huzican/15th_SmartCar_SoundBeacon/code/README.md

- SoundBeacon是最终比赛代码，规则是声音信标组

- RBRB(image)是11月出的多灯光电信标组，当年做过信标组的兄弟都知道，信标组3月份才从光电改成声音信号，还碰上疫情和赛事挂名单位改革，真的是太难了那年

- fft是matlab测试傅里叶加速算法
