huzican/15th_SmartCar_SoundBeacon/(list of files, drawings)

Other design files:
board/红黑红黑的小黄鸡二队主板/红黑红黑的小黄鸡二队区赛2.0.PcbDoc
board/红黑红黑的小黄鸡二队主板/红黑红黑的小黄鸡二队区赛2.0Mainboard.SchDoc
board/红黑红黑的小黄鸡二队驱动.PcbDoc
board/驱动区赛.SchDoc
board/龙邱MIC转接板.SchDoc
