huzican/15th_SmartCar_SoundBeacon/code/RBRB(image)/Main_RT/CODE/inc/Pid.h

#ifndef __PID_H__
#define __PID_H__

#include "common.h"


typedef struct PID
{
  float err_1,err_2,err_3;
  float err;
  float kp,ki,kd;
  float last_d,d_filter;
  int16 result;
}pid_t;


extern pid_t pid_F_L;
extern pid_t pid_F_R;
extern pid_t pid_B_L;
extern pid_t pid_B_R;
extern pid_t pid_far;
extern pid_t pid_near;
extern pid_t pid_yaw;
extern pid_t pid_yaw_rate;
extern float FP;
extern float NP;
extern float YP;
extern float YD;
extern float YRP;
extern float YRD;


void pid_init(void);
void pid_reset(pid_t *pid);
void pid_control(pid_t *pid, int16 actual, int16 set);

#endif
