huzican/15th_SmartCar_SoundBeacon/code/RBRB(image)/Main_RT/CODE/src/FuzzySet_Speed.c

#include "common.h"
#include "math.h"
#include "FuzzySet_Speed.h"
#include "Image.h"
#include "Motor.h"

const int16 PMAX = 75;
const int16 PMIN = 30;

int16 DMAX;
int16 DMIN;

const int16 SMAX = 100;     //两个参数都统一到0~100(归一化)
const int16 SMIN = 0;
const int16 FMAX = 100;     //语言值的满幅值
              //0   1   2   3   4   5   6
int16 PFF[7] = {0, 16, 32, 48, 64, 80, 96}; //统一到最大值；最小值
int16 DFF[7] = {0, 40, 50, 60, 70, 80, 90};
/***输出量U语言值特征点 0  1   2   3   4   5   6***/
int16 N_UFF1[7] = {200, 220, 240, 250, 260, 275, 290};
int16 F_UFF1[7] = {300, 320, 340, 360, 380, 400, 420};

int16 N_UFF2[7] = {200, 220, 230, 240, 250, 260, 270};
int16 F_UFF2[7] = {270, 280, 285, 295, 305, 320 ,335};

int16 N_UFF3[7] = {200, 220, 240, 250, 260, 275, 290};
int16 F_UFF3[7] = {300, 320, 340, 360, 380, 400 ,415};

int16 N_UFF4[7] = {200, 220, 240, 250, 260, 275, 290};
int16 F_UFF4[7] = {300, 320, 340, 360, 380, 400 ,415};

uint16 rule[7][7] =
{   /*Track_complexity */  //  0,  1,  2,  3,  4,  5,  6    Prospect_See
                  /* 0 */     {6,  5,  4,  3,  2,  1,  0,}, //U语言数组里面的下标
                  /* 1 */     {5,  5,  4,  3,  2,  1,  0,},      
                  /* 2 */     {4,  4,  3,  2,  1,  1,  0,},
                  /* 3 */     {3,  3,  3,  2,  1,  1,  0,},
                  /* 4 */     {2,  2,  2,  1,  1,  0,  0,},
                  /* 5 */     {2,  1,  1,  0,  0,  0,  0,}, 
                  /* 6 */     {1,  1,  0,  0,  0,  0,  0,}
};  //横D竖P

int16 *UFF;

//P代表赛道复杂程度
//D表示前瞻
//模糊控制算法通过这两个跟定量以及规则表给出当前应该输出的速度
int16 FuzzySet_Speed(int16 P, int16 D)
{
  int16 U;      //偏差，以及输出值的精确量
  uint16 PF[2];
  uint16 DF[2];
  uint16 UF[4]; //偏差，偏差微分以及输出值的隶属度 PF[1]是P的隶属度,PF[0]是隶属度的补集
  int16 Pn = 0, Dn = 0;
  int16 Un[4];
  int32 temp1, temp2;
  
  if(P < PMIN)
    P = PMIN;
  else if(P > PMAX)
    P = PMAX;
  P = (int16)((double)(P - PMIN)/(PMAX - PMIN)*(SMAX - SMIN) + SMIN);
  
  if(D < DMIN)
    D = DMIN;
  else if(D > DMAX)
    D = DMAX;
  D = (int16)((double)(D - DMIN)/(DMAX - DMIN)*(SMAX-SMIN)+SMIN);
  
  //隶属度的确定
  //根据PD的指定语言获得有效的隶属度
  if(P > PFF[0]&&P <PFF[6])
  {
    if(P <= PFF[1])
    {
      Pn = 1;
      PF[0] = (uint16)(FMAX *((float)(PFF[1]-P)/(PFF[1]-PFF[0])));
    }
    else if(P <= PFF[2])
    {
      Pn = 2;
      PF[0] = (uint16)(FMAX * ((float)(PFF[2]-P)/(PFF[2]-PFF[1])));
    }
    else if(P <= PFF[3])
    {
      Pn = 3;
      PF[0] = (uint16)(FMAX * ((float)(PFF[3]-P)/(PFF[3]-PFF[2])));
    }
    else if(P <= PFF[4])
    {
      Pn = 4;
      PF[0] = (uint16)(FMAX * ((float)(PFF[4]-P)/(PFF[4]-PFF[3])));
    }
    else if(P <= PFF[5])
    {
      Pn = 5;
      PF[0] = (uint16)(FMAX * ((float)(PFF[5]-P)/(PFF[5]-PFF[4])));
    }
    else if(P <= PFF[6])
    {
      Pn = 6;
      PF[0] = (uint16)(FMAX * ((float)(PFF[6]-P)/(PFF[6]-PFF[5])));
    }
  }
  else if(P <= PFF[0])
  {
    Pn = 1;
    PF[0] = (uint16)(FMAX);
  }
  else if(P >= PFF[6])
  {
    Pn=6;
    PF[0] = 0;
  }
  
  PF[1] = (uint16)(FMAX - PF[0]);
  
  if(D > DFF[0]&&D < DFF[6])
  {
    if(D <= DFF[1])
    {
      Dn = 1;
      DF[0] = (uint16)(FMAX * ((float)(DFF[1]-D)/(DFF[1]-DFF[0])));
    }
    else if(D <= DFF[2])
    {
      Dn = 2;
      DF[0] = (uint16)(FMAX * ((float)(DFF[2]-D)/(DFF[2]-DFF[1])));
    }
    else if(D <= DFF[3])
    {
      Dn = 3;
      DF[0] = (uint16)(FMAX * ((float)(DFF[3]-D)/(DFF[3]-DFF[2])));
    }
    else if(D <= DFF[4])
    {
      Dn = 4;
      DF[0] = (uint16)(FMAX * ((float)(DFF[4]-D)/(DFF[4]-DFF[3])));
    }
    else if(D <= DFF[5])
    {
      Dn = 5;
      DF[0] = (uint16)(FMAX * ((float)(DFF[5]-D)/(DFF[5]-DFF[4])));
    }
    else if(D <= DFF[6])
    {
      Dn = 6;
      DF[0] = (uint16)(FMAX * ((float)(DFF[6]-D)/(DFF[6]-DFF[5])));
    }
  }
  else if(D <= DFF[0])
  {
    Dn = 1;
    DF[0] = (uint16)(FMAX);
  }
  else if(D >= DFF[6])
  {
    Dn = 6;
    DF[0] = 0;
  }
  
  DF[1] = (uint16)(FMAX - DF[0]);
  
  //使用误差范围优化后的规则表rule[7][7]
  //输出值使用13个隶属函数，中心值由UFF[7]指定
  //一般都是四个规则有效
  Un[0] = rule[Pn-1][Dn-1];
  Un[1] = rule[Pn][Dn-1];
  Un[2] = rule[Pn-1][Dn];
  Un[3] = rule[Pn][Dn];
  
  if(PF[0] <= DF[0])//计算R表，隶属函数求交集
    UF[0] = PF[0];
  else
    UF[0] = DF[0];
  
  if(PF[1] < DF[0])
    UF[1] = PF[1];
  else
    UF[1] = DF[0];
  
  if(PF[0] <= DF[1])
    UF[2] = PF[0];
  else
    UF[2] = DF[1];
  
  if(PF[1] <= DF[1])
    UF[3] = PF[1];
  else
    UF[3] = DF[1];
  
  //同隶属函数输出语言值求大
  if(Un[0] == Un[1])
  {
    if(UF[0] > UF[1])
      UF[1] = 0;
    else
      UF[0] = 0;
  }
  if(Un[0] == Un[2])
  {
    if(UF[0] > UF[2])
      UF[2] = 0;
    else
      UF[0] = 0;
  }
  if(Un[0] == Un[3])
  {
    if(UF[0] > UF[3])
      UF[3] = 0;
    else
      UF[0] = 0;
  }
  if(Un[1] == Un[2])
  {
    if(UF[1] > UF[2])
      UF[2] = 0;
    else 
      UF[1] = 0;
  }
  if(Un[1] == Un[3])
  {
    if(UF[1] > UF[3])
      UF[3] = 0;
    else
      UF[1] = 0;
  }
  if(Un[2] == Un[3])
  {
    if(UF[2] > UF[3])
      UF[3] = 0;
    else
      UF[2] = 0;
  }
  
  //重心法(按隶属度加权平均)反模糊
  //Un[]原值为输出隶属函数标号，转换为隶属函数值
  Un[0] = UFF[Un[0]];
  Un[1] = UFF[Un[1]];
  Un[2] = UFF[Un[2]];
  Un[3] = UFF[Un[3]];
  
  temp1 = UF[0] * Un[0] + UF[1] *Un[1] +UF[2] * Un[2] + UF[3] * Un[3];
  temp2 = UF[0] +UF[1] +UF[2] +UF[3];
  U = (int16)(temp1 / temp2);
  return U;
}

void set_UFF()
{
  if(beacon_dis == FarBeacon)
  {
    DMAX = 32;
    DMIN = 17;
    if(speed_level == 1)         UFF = F_UFF1;
    else if(speed_level == 2)    UFF = F_UFF2;
    else if(speed_level == 3)    UFF = F_UFF3;
    else if(speed_level == 4)    UFF = F_UFF4;
  }
  else if(beacon_dis == NearBeacon)
  {
    DMAX = 35;
    DMIN = 10;
    if(speed_level == 1)        UFF = N_UFF1;
    else if(speed_level == 2)   UFF = N_UFF2;
    else if(speed_level == 3)   UFF = N_UFF3;
    else if(speed_level == 4)   UFF = N_UFF4;
  }
}
