huzican/15th_SmartCar_SoundBeacon/code/RBRB(image)/Main_RT/CODE/inc/RDA5807.h

///*********************************************************************************************************************
//					接线定义：
//					------------------------------------
//						软件IIC
//                        SCL                 查看SEEKFREE_IIC文件内的SEEKFREE_SCL宏定义
//						SDA                 查看SEEKFREE_IIC文件内的SEEKFREE_SDA宏定义
//
//                        硬件IIC
//                        SCL                 查看init_mpu6050_hardware函数内IIC初始化时所带参数
//						SDA                 查看init_mpu6050_hardware函数内IIC初始化时所带参数
//					------------------------------------
//					注意事项：RDA5807的SCL与SDA都需要串联1K电阻然后在与单片机连接，否则可能无法通信
// ********************************************************************************************************************/
//
//
//#ifndef _FM5807_H
//#define _FM5807_H
//#include "common.h"
//#include "SEEKFREE_FONT.h"
//
//
//
//
//
//
//
//
//
//
//void rda5807_init(float freq);
//void rda5807_set_transimt(void);
//void rda5807_set_idle(void);
//void rda5807_set_channel(float freq);
//void rda5807_channel_config(uint16 reg_chn);
//
//
//#endif
//
//
