huzican/15th_SmartCar_SoundBeacon/code/RBRB(image)/Main_RT/CODE/inc/include.h

#ifndef __INCLUDE_H__
#define __INCLUDE_H__


#include "BMX055.h"
#include "Camera.h"
#include "image.h"
#include "DirControl.h"
#include "Encoder.h"
#include "Filter.h"
#include "FuzzySet_Speed.h"
#include "InfraredDetector.h"
#include "Motor.h"
#include "Pid.h"
#include "Posture.h"
#include "TFmini.h"

#endif
