huzican/15th_SmartCar_SoundBeacon/code/RBRB(image)/Main_RT/CODE/inc/Posture.h

#ifndef  _POSTURE_H_
#define  _POSTURE_H_

#include "common.h"

#define    SPIN_COE      3.8
#define    SAMPLE_RATE   0.005

typedef struct car_status
{
  float yaw[5];                 //偏航角
  float yaw_rate[5];            //偏航角速度
  float ideal_yaw_rate;
}car_status;
extern car_status car;

/*****GYRO*****/
typedef struct{
  float X_data;
  float Y_data;
  float Z_data;
  uint8 GYRO_CAL_FLAG;
}Gyrotypedef;
extern Gyrotypedef Gyro;

void get_posture();
void Kalman_filter();

extern void get_posture();
extern void Kalman_filter();



#endif
