huzican/15th_SmartCar_SoundBeacon/(notices)

Notices in the files:
code/RBRB(image)/Main_RT/USER/src/isr.c:
Copyright (c) 2019,Öð·É¿Æ¼¼
All rights reserved.
